SantiagoPreves/Trabajo-Final-CAN/docs/Figuras y graficos/montaje_protoboard.jpeg

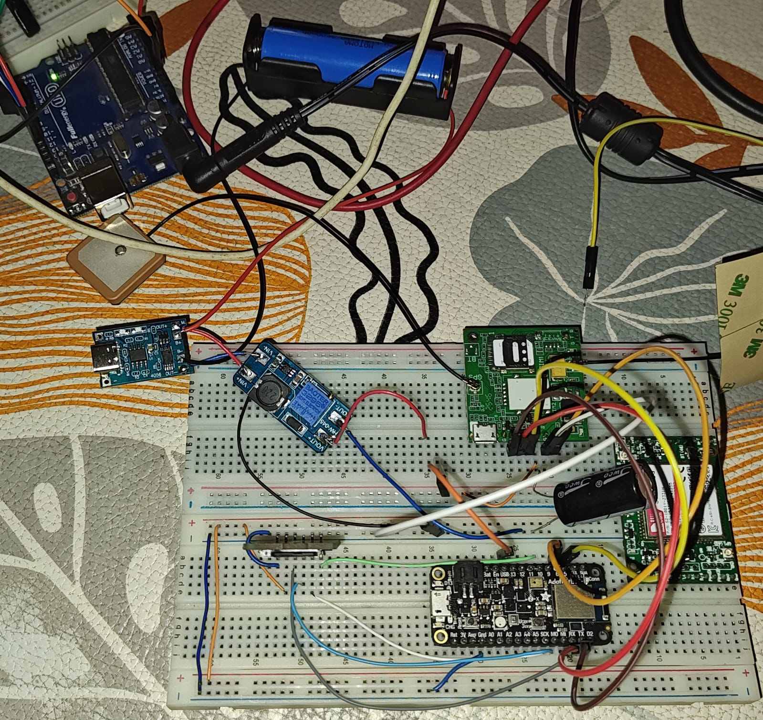
docs/Figuras y graficos/montaje_protoboard.jpeg
