SantiagoPreves/Trabajo-Final-CAN/docs/Figuras y graficos/gndopen.jpeg

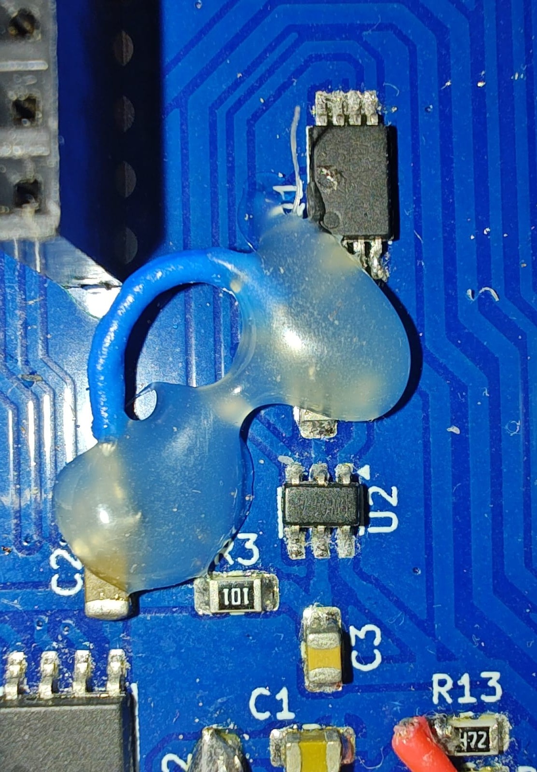
docs/Figuras y graficos/gndopen.jpeg
