SantiagoPreves/Trabajo-Final-CAN/docs/PProy_Preves_v1.pdf

Fecha: 25 de junio de 2026 | Versión 1.0

## UNMDP-FI

## Carrera: Ingeniería Electrónica

## Plan de Proyecto

## Sistema de monitoreo de fallas y datos de manejo de vehículos

Preves, Santiago

Sistema de monitoreo de fallas y datos de manejo de vehículos Plan de Proyecto

Fecha: 25/06/2026 | Versión 1.0 | Página 2 de 5
Fecha | Versión | Descripción | Autor/a
25/06/2026 | 1.0 | Versión inicial | Preves, Santiago

Índice

### 1. Introducción

Este documento contiene la especificación de requerimientos del proyecto de desarrollo de Sistema de monitoreo de fallas y datos de manejo de vehículos. Dicho proyecto se realiza en conjunto con el LIVRA, Facultad de Ingeniería, UNMDP.

- Título propuesto: “Sistema de monitoreo de fallas y datos de manejo de vehículos”.
- Estudiante: Preves, Santiago.
- Directores: Lopez, Juan Manuel - Director.
Russo, Rodrigo- Co-director.
- Lugar de desarrollo: Laboratorio de Instrumentación Virtual y Robótica Aplicada (LIVRA), Instituto de Investigaciones Científicas y Tecnológicas en Electrónica (ICyTE), UNMDP.

El siguiente documento corresponde al plan de proyecto, lo componen 3 partes:

- Cronograma preliminar propuesto
- Estimación de riesgos

### 2. Planificación

### 2.1 Cronograma propuesto

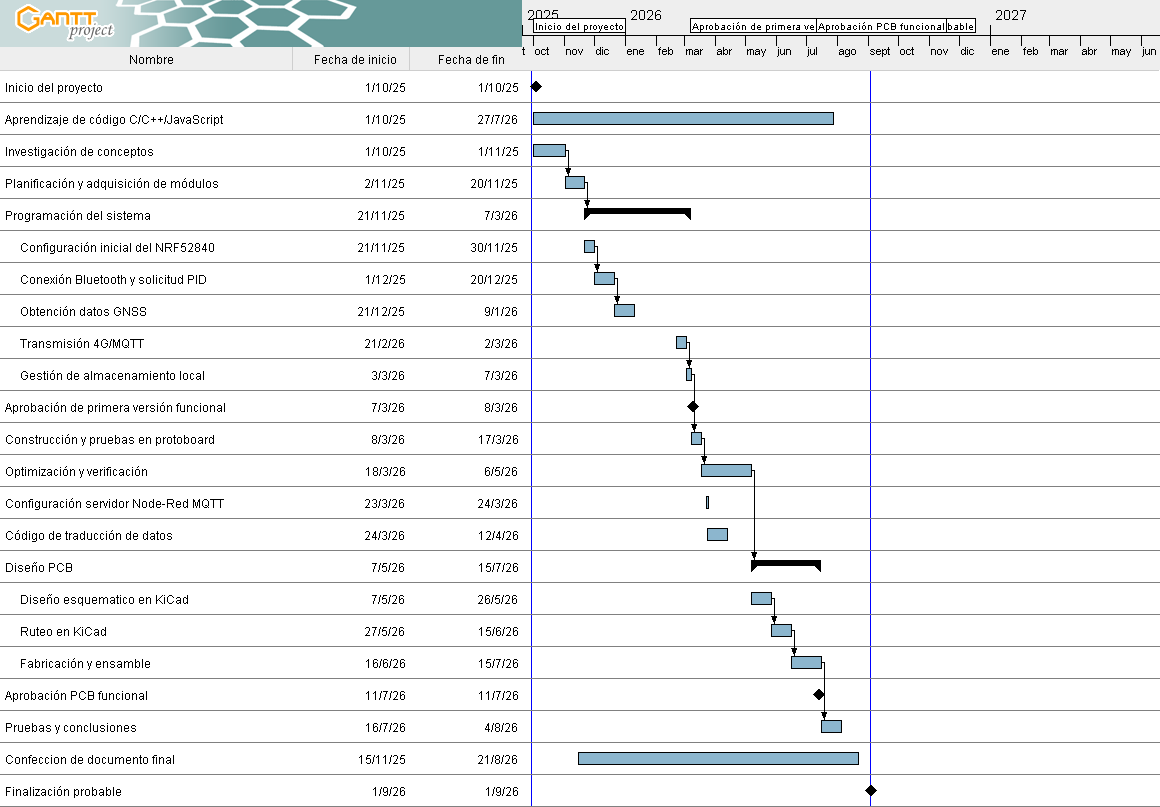
[picture p20: figure]

### 2.2 Riesgos identificados

El cronograma se realizó teniendo en cuenta tiempos extra en algunas tareas, con el fin de cubrirse de la aparición de inconvenientes con el fin de minimizar los efectos que estos puedan ocasionar en el cronograma.
En la siguiente tabla se detallan los riesgos considerados junto con la severidad, que es una medida del retraso que generaría en el cronograma. También se indica la probabilidad de que ese inconveniente aparezca. La combinación entre severidad y probabilidad da la medida de prioridad siendo los que tengan mayor severidad y mayor probabilidad una prioridad más alta.
Riesgo | Probabilidad de aparición | Severidad | Plan de respuesta
Comenzar a trabajar | Alta | Alta | Acelerar plazos previstos para esa fecha, de modo de compensar tiempos
Rotura de microcontrolador/módulo 4G | Baja | Alta | Adquisición de un nuevo módulo, se atrasa el calendario
Faltante en componentes | Baja | Baja | Se cambia de fabricante/se compra en el exterior
