SantiagoPreves/Trabajo-Final-CAN/docs/Figuras y graficos/carcasa1.png

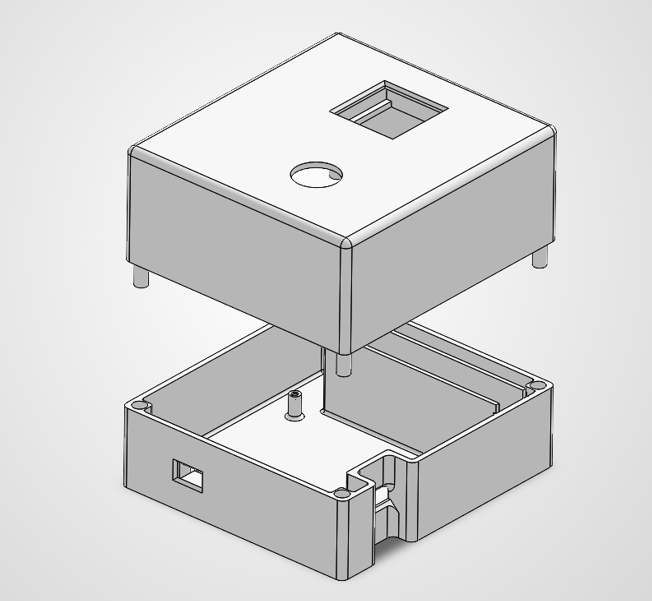
docs/Figuras y graficos/carcasa1.png
