SantiagoPreves/Trabajo-Final-CAN/docs/Figuras y graficos/carcasa2.png

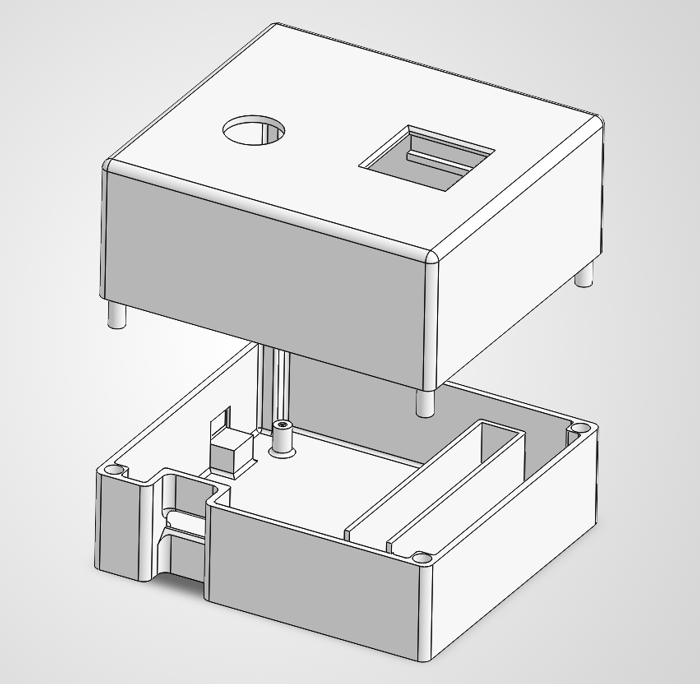
docs/Figuras y graficos/carcasa2.png
