SantiagoPreves/Trabajo-Final-CAN/docs/Figuras y graficos/carcasa_abierta.png

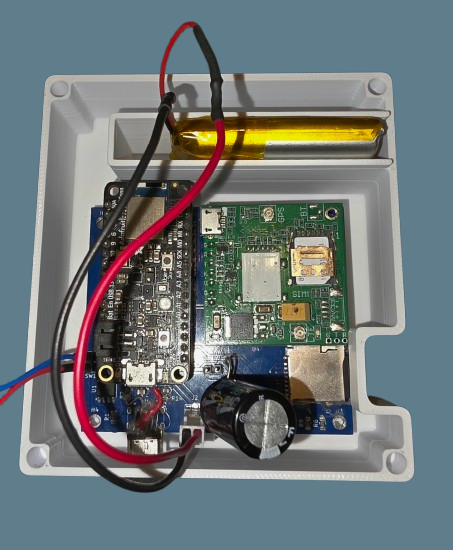
docs/Figuras y graficos/carcasa_abierta.png
