SantiagoPreves/Trabajo-Final-CAN/docs/Figuras y graficos/carcasa_general.png

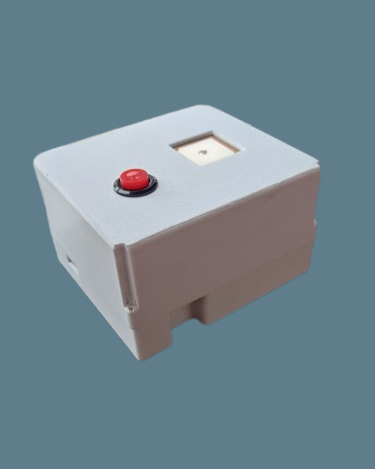
docs/Figuras y graficos/carcasa_general.png
