SantiagoPreves/Trabajo-Final-CAN/docs/Figuras y graficos/carcasa_superior.png

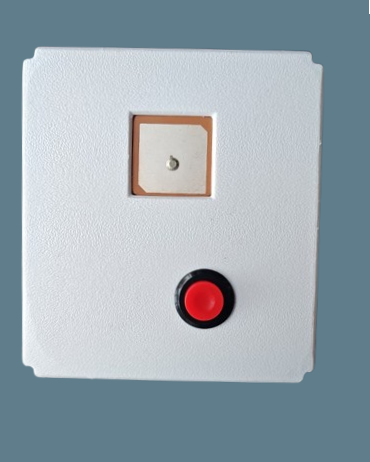
docs/Figuras y graficos/carcasa_superior.png
