SantiagoPreves/Trabajo-Final-CAN/docs/Figuras y graficos/GPS_bottom.png

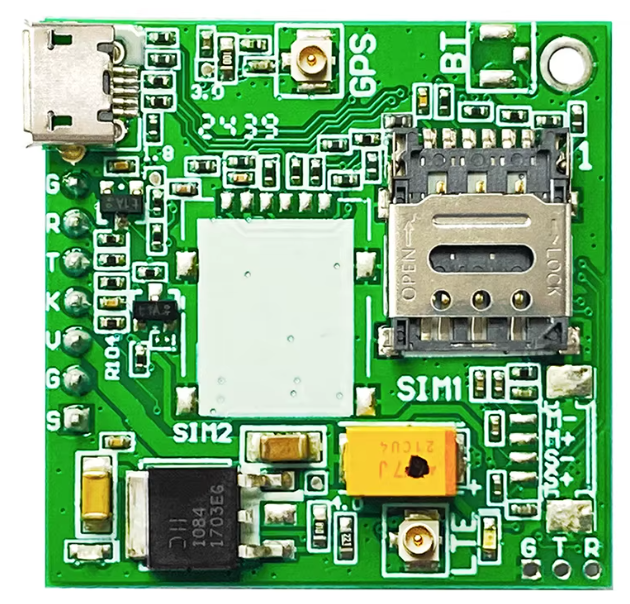
docs/Figuras y graficos/GPS_bottom.png
