SantiagoPreves/Trabajo-Final-CAN/docs/Figuras y graficos/GPS_top.png

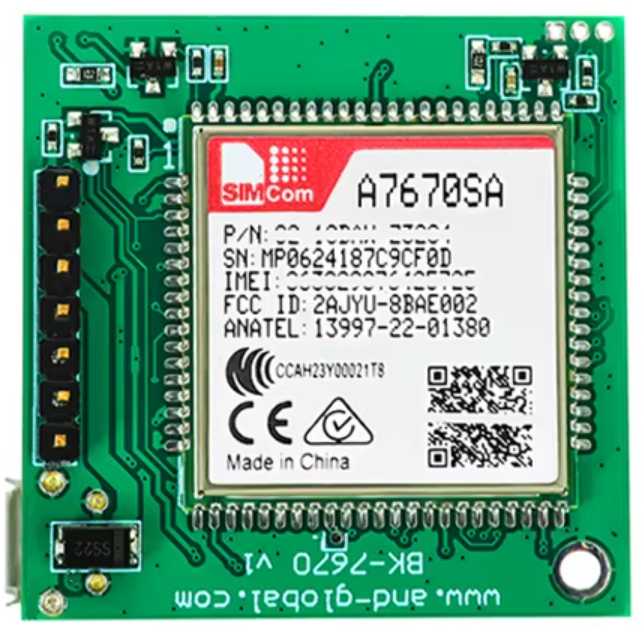
docs/Figuras y graficos/GPS_top.png
