SantiagoPreves/Trabajo-Final-CAN/docs/Figuras y graficos/micro_top.jpg

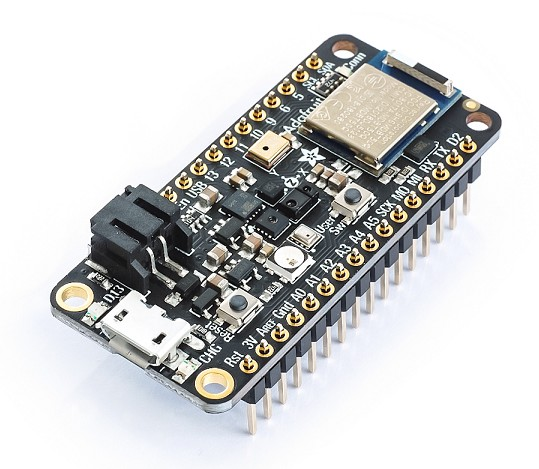
docs/Figuras y graficos/micro_top.jpg
