SantiagoPreves/Trabajo-Final-CAN/docs/Figuras y graficos/nodered.png

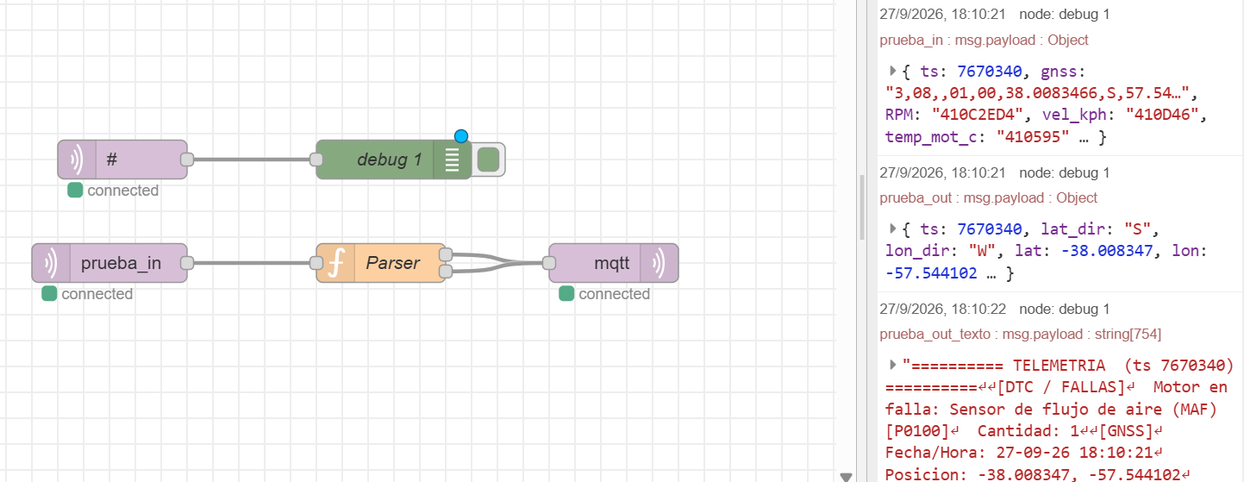
docs/Figuras y graficos/nodered.png
