SantiagoPreves/Trabajo-Final-CAN/docs/Figuras y graficos/SD_ejemplo.png

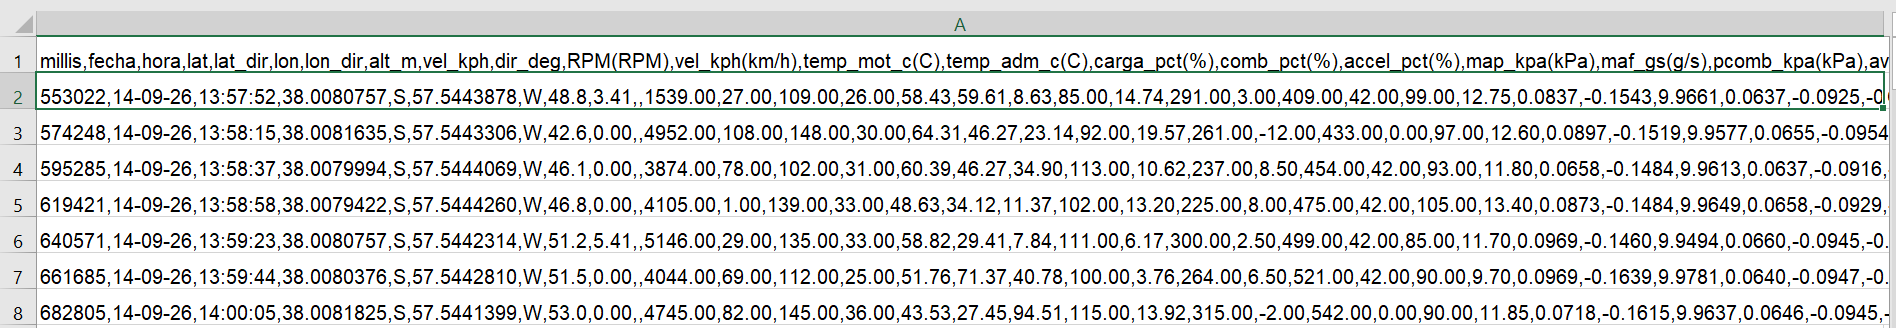
docs/Figuras y graficos/SD_ejemplo.png
