SantiagoPreves/Trabajo-Final-CAN/docs/Figuras y graficos/stencil.png

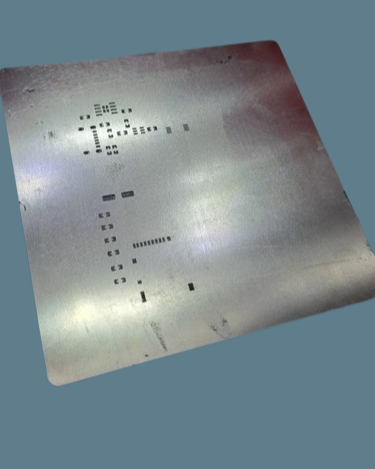
docs/Figuras y graficos/stencil.png
