SantiagoPreves/Trabajo-Final-CAN/test/mediciones_corriente_24-09/medicion_cada_15s.csv

No. | Date/Time | Function | Range | Value | Unit
1 | 2026-09-24 11:40:37 | DCmA | 60 | 0.00 | mA
2 | 2026-09-24 11:40:38 | DCmA | 600 | 0.0 | mA
3 | 2026-09-24 11:40:38 | DCmA | 600 | 72.6 | mA
4 | 2026-09-24 11:40:38 | DCmA | 600 | 73.0 | mA
5 | 2026-09-24 11:40:38 | DCmA | 600 | 74.0 | mA
6 | 2026-09-24 11:40:39 | DCmA | 600 | 81.3 | mA
7 | 2026-09-24 11:40:39 | DCmA | 600 | 81.1 | mA
8 | 2026-09-24 11:40:39 | DCmA | 600 | 81.3 | mA
9 | 2026-09-24 11:40:40 | DCmA | 600 | 80.1 | mA
10 | 2026-09-24 11:40:40 | DCmA | 600 | 77.8 | mA
11 | 2026-09-24 11:40:40 | DCmA | 600 | 106.1 | mA
12 | 2026-09-24 11:40:41 | DCmA | 600 | 94.5 | mA
13 | 2026-09-24 11:40:41 | DCmA | 600 | 104.0 | mA
14 | 2026-09-24 11:40:41 | DCmA | 600 | 92.0 | mA
15 | 2026-09-24 11:40:42 | DCmA | 600 | 201.9 | mA
16 | 2026-09-24 11:40:42 | DCmA | 600 | 231.0 | mA
17 | 2026-09-24 11:40:42 | DCmA | 600 | 298.7 | mA
18 | 2026-09-24 11:40:43 | DCmA | 600 | 296.2 | mA
19 | 2026-09-24 11:40:43 | DCmA | 600 | 277.7 | mA
20 | 2026-09-24 11:40:43 | DCmA | 600 | 151.8 | mA
21 | 2026-09-24 11:40:44 | DCmA | 600 | 80.3 | mA
22 | 2026-09-24 11:40:44 | DCmA | 600 | 83.3 | mA
23 | 2026-09-24 11:40:44 | DCmA | 600 | 76.6 | mA
24 | 2026-09-24 11:40:45 | DCmA | 600 | 81.9 | mA
25 | 2026-09-24 11:40:45 | DCmA | 600 | 74.2 | mA
26 | 2026-09-24 11:40:45 | DCmA | 600 | 76.0 | mA
27 | 2026-09-24 11:40:46 | DCmA | 600 | 82.8 | mA
28 | 2026-09-24 11:40:46 | DCmA | 600 | 80.5 | mA
29 | 2026-09-24 11:40:46 | DCmA | 600 | 76.7 | mA
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
645 | 2026-09-24 11:44:10 | DCmA | 600 | 271.0 | mA
646 | 2026-09-24 11:44:10 | DCmA | 600 | 251.0 | mA
647 | 2026-09-24 11:44:11 | DCmA | 600 | 236.3 | mA
648 | 2026-09-24 11:44:11 | DCmA | 600 | 236.3 | mA
649 | 2026-09-24 11:44:11 | DCmA | 600 | 234.9 | mA
