SantiagoPreves/Trabajo-Final-CAN/hardware/Kicad/Monitores_de_camiones/FS8205A/FS8205A.step

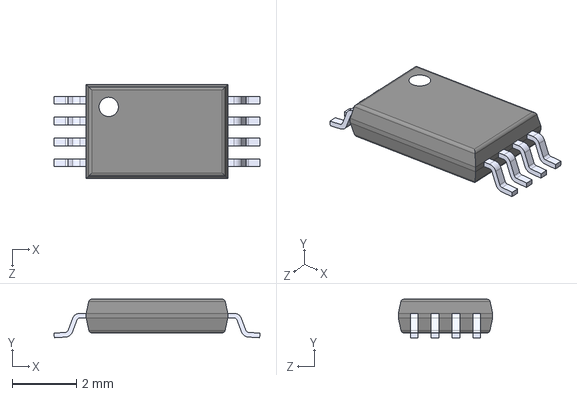
[picture p33: CAD file, 2026-09-22]
hardware/Kicad/Monitores_de_camiones/FS8205A/FS8205A.step
6.40 x 1.20 x 2.93 mm
