SantiagoPreves/Trabajo-Final-CAN/test/pruebas_anteriores/2026-09-13_dtc/trad.csv

millis | fecha | hora | lat | lat_dir | lon | lon_dir | alt_m | vel_kph | dir_deg | RPM(RPM) | vel_kph(km/h) | temp_mot_c(C) | temp_adm_c(C) | carga_pct(%) | comb_pct(%) | accel_pct(%) | map_kpa(kPa) | maf_gs(g/s) | pcomb_kpa(kPa) | avance_deg(deg) | ton_s(s) | dist_mil_km(km) | temp_ace_c(C) | cons_lh(L/h) | imu_ax(m/s2) | imu_ay(m/s2) | imu_az(m/s2) | imu_gx(rad/s) | imu_gy(rad/s) | imu_gz(rad/s) | vbat(V) | cargando | carga_completa | dtc | dtc_alerta
41723 |  |  |  |  |  |  |  |  |  | ERR | 101.00 | 145.00 | 20.00 | 54.90 | 22.75 | 18.82 | 107.00 | 7.50 | 243.00 | -2.50 | 1982.00 | 42.00 | 114.00 | 11.65 | -0.1256 | -0.2321 | 9.9649 | 0.0652 | -0.1032 | -0.0860 | 4.18 | 1 | 0 | P0100;U1000 | Motor en falla: Sensor de flujo de aire (MAF) [P0100] | Red/Comunicacion en falla: Comunicacion en red CAN [U1000]
62243 |  |  |  |  |  |  |  |  |  | 4927.00 | 67.00 | 145.00 | 31.00 | 55.69 | 65.10 | 80.78 | 115.00 | 5.24 | 213.00 | 4.50 | 2002.00 | 42.00 | 101.00 | 10.15 | -0.1268 | -0.2417 | 9.9829 | 0.0644 | -0.1009 | -0.0848 | 4.16 | 1 | 0 | P0100;U1000 | Motor en falla: Sensor de flujo de aire (MAF) [P0100] | Red/Comunicacion en falla: Comunicacion en red CAN [U1000]
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
