SantiagoPreves/Trabajo-Final-CAN/test/pruebas_anteriores/2026-09-27_rev5_15_ciclos/trad.csv

millis | fecha | hora | lat | lat_dir | lon | lon_dir | alt_m | vel_kph | dir_deg | RPM(RPM) | vel_kph(km/h) | temp_mot_c(C) | carga_pct(%) | accel_pct(%) | imu_ax(m/s2) | imu_ay(m/s2) | imu_az(m/s2) | imu_gx(rad/s) | imu_gy(rad/s) | imu_gz(rad/s) | vbat(V) | cargando | carga_completa | dtc
101351 |  |  |  |  |  |  |  |  |  | 2542.00 | 46.00 | 149.00 | 72.55 | 72.94 | 0.2668 | 0.5037 | 9.9984 | 0.0661 | -0.0904 | -0.1300 | 4.19 | 1 | 0 | U1000
302178 |  |  |  |  |  |  |  |  |  | 4040.00 | 30.00 | 122.00 | 73.33 | 94.51 | 0.2345 | 0.5121 | 9.9362 | 0.0672 | -0.0919 | -0.1271 | 4.12 | 1 | 0 | none
501611 |  |  |  |  |  |  |  |  |  | 5621.00 | 51.00 | 114.00 | 58.82 | 97.25 | 0.2321 | 0.5085 | 9.9003 | 0.0663 | -0.0886 | -0.1283 | 4.12 | 1 | 0 | P0100
703270 |  |  |  |  |  |  |  |  |  | 1548.00 | 113.00 | 144.00 | 48.24 | 8.63 | 0.2357 | 0.5109 | 9.8704 | 0.0658 | -0.0895 | -0.1280 | 4.12 | 1 | 0 | P0420;C0110
906619 |  |  |  |  |  |  |  |  |  | 3838.00 | 101.00 | 146.00 | 68.24 | 49.80 | 0.2572 | 0.5157 | 9.8728 | 0.0664 | -0.0878 | -0.1283 | 4.13 | 1 | 0 | B0010;U1000
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
