SantiagoPreves/Trabajo-Final-CAN/test/prueba_final/TRAD.CSV

millis | fecha | hora | lat | lat_dir | lon | lon_dir | alt_m | vel_kph | dir_deg | RPM(RPM) | vel_kph(km/h) | temp_mot_c(C) | carga_pct(%) | accel_pct(%) | imu_ax(m/s2) | imu_ay(m/s2) | imu_az(m/s2) | imu_gx(rad/s) | imu_gy(rad/s) | imu_gz(rad/s) | vbat(V) | cargando | carga_completa | dtc
106625 |  |  |  |  |  |  |  |  |  | 2879.00 | 23.00 | 126.00 | 58.82 | 44.71 | 0.0814 | 0.0526 | 9.9506 | 0.0632 | -0.0886 | -0.1126 | 4.17 | 1 | 0 | U0100;U0121
270035 | 27-09-26 | 19:07:01 | 38.0079651 | S | 57.5440445 | W | 107.4 | 2.17 | 0 | 2231.00 | 75.00 | 125.00 | 70.20 | 85.49 | 0.0682 | 0.0419 | 9.9326 | 0.0623 | -0.0916 | -0.1101 | 4.16 | 1 | 0 | P0420;U1000
450420 | 27-09-26 | 19:10:01 | 38.0080109 | S | 57.5440445 | W | 102.9 | 2.18 | 0 | 2183.00 | 8.00 | 117.00 | 60.78 | 20.00 | 0.0861 | 0.0383 | 9.9206 | 0.0632 | -0.0924 | -0.1101 | 4.17 | 1 | 0 | C0035;P0128
680596 | 27-09-26 | 19:13:51 | 38.0080299 | S | 57.5441360 | W | 64.4 | 0.58 | 0 | 2950.00 | 104.00 | 149.00 | 66.27 | 63.92 | 0.0646 | 0.0395 | 9.9266 | 0.0638 | -0.0933 | -0.1115 | 4.17 | 1 | 0 | C0035;P0128
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
