SantiagoPreves/Trabajo-Final-CAN/test/pruebas_anteriores/2026-09-10_sin_gestion/SD-sin-DTC-10-09.CSV

millis | fecha | hora | lat | lat_dir | lon | lon_dir | alt_m | vel_kph | dir_deg | RPM(RPM) | vel_kph(km/h) | temp_mot_c(C) | temp_adm_c(C) | carga_pct(%) | comb_pct(%) | accel_pct(%) | map_kpa(kPa) | maf_gs(g/s) | pcomb_kpa(kPa) | avance_deg(deg) | ton_s(s) | dist_mil_km(km) | temp_ace_c(C) | cons_lh(L/h) | imu_ax(m/s2) | imu_ay(m/s2) | imu_az(m/s2) | imu_gx(rad/s) | imu_gy(rad/s) | imu_gz(rad/s) | vbat(V) | cargando | carga_completa
69293 | 10-09-26 | 13:14:55 | 38.0125198 | S | 57.5814056 | W | 66.3 | 1.47 |  | ERR | 101.00 | 140.00 | 31.00 | 54.12 | 41.96 | 29.80 | 110.00 | 12.40 | 297.00 | 3.50 | 827.00 | 42.00 | 86.00 | 13.60 | 0.1304 | -0.3840 | 9.9960 | 0.0680 | -0.0939 | -0.1078 | 3.89 | 0 | 0
89220 | 10-09-26 | 13:15:18 | 38.0126572 | S | 57.5815392 | W | 60.2 | 3.29 |  | 2698.00 | 15.00 | 119.00 | 34.00 | 48.24 | 74.12 | 31.37 | 105.00 | 9.26 | 279.00 | -1.00 | 850.00 | 42.00 | 93.00 | 13.50 | 0.1161 | -0.3685 | 10.0056 | 0.0678 | -0.0950 | -0.1081 | 3.88 | 0 | 0
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
