SantiagoPreves/Trabajo-Final-CAN/test/mediciones_corriente_24-09/medicion_cada_5m_modo2.jpg

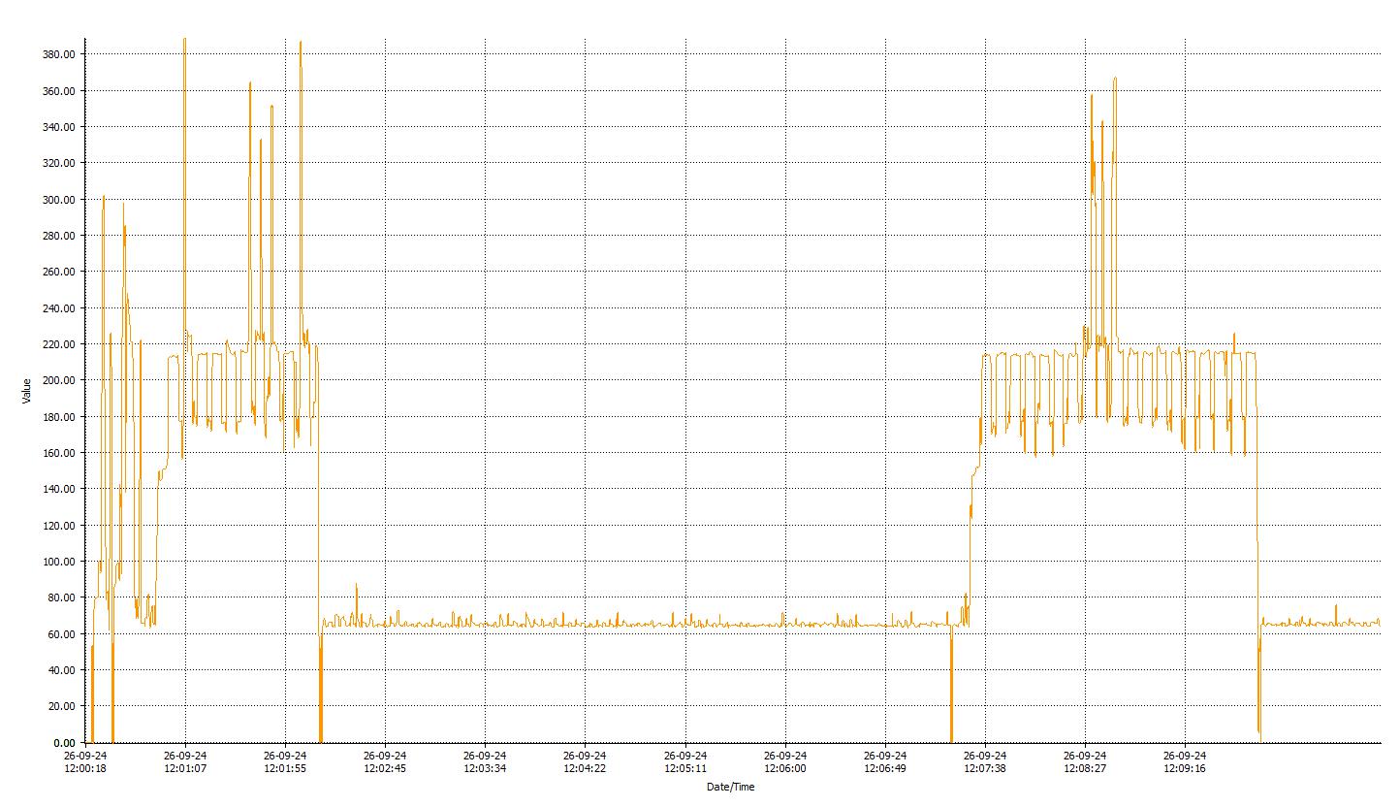
test/mediciones_corriente_24-09/medicion_cada_5m_modo2.jpg
