SantiagoPreves/Trabajo-Final-CAN/test/mediciones_corriente_24-09/medicion_cada_15s.jpg

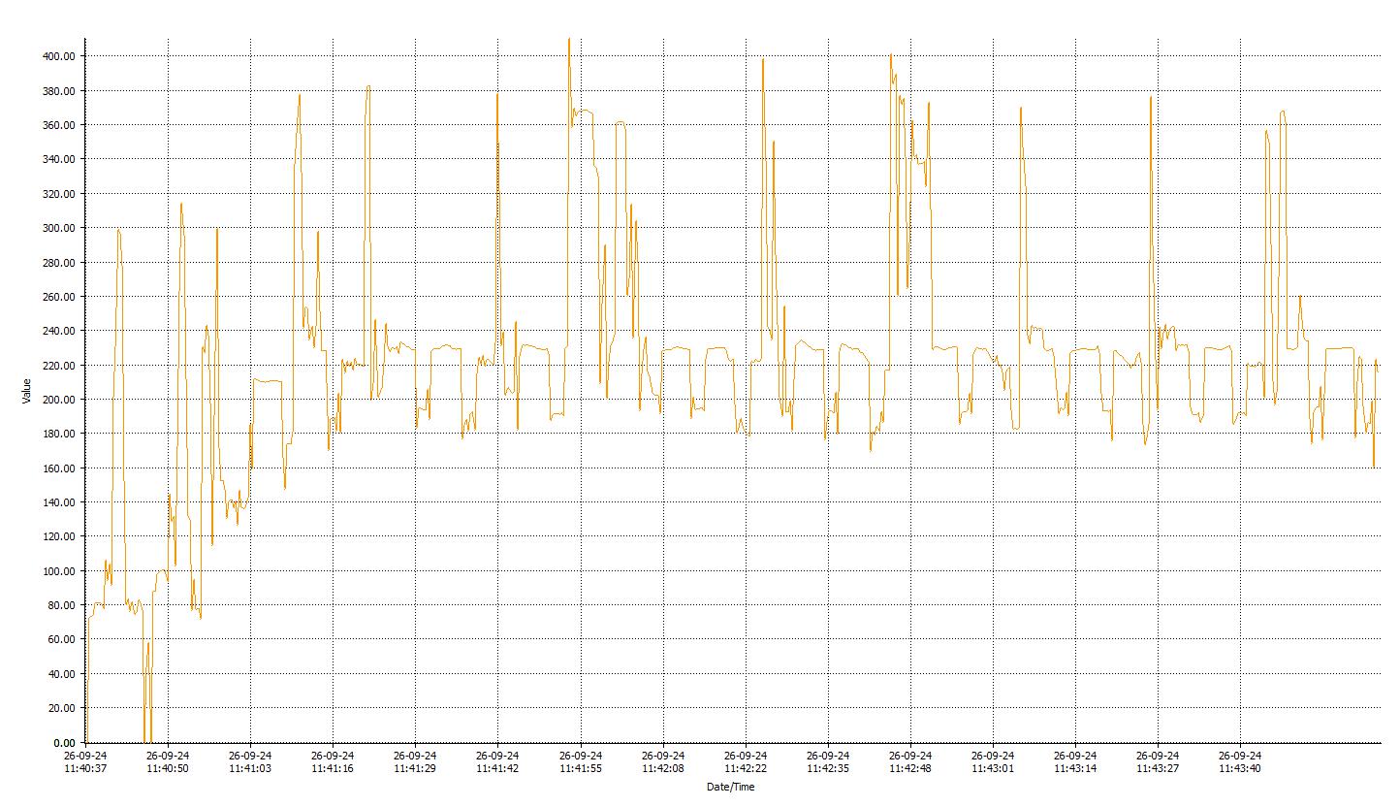
test/mediciones_corriente_24-09/medicion_cada_15s.jpg
