SantiagoPreves/Trabajo-Final-CAN/docs/Figuras y graficos/arquitectura_software.pdf

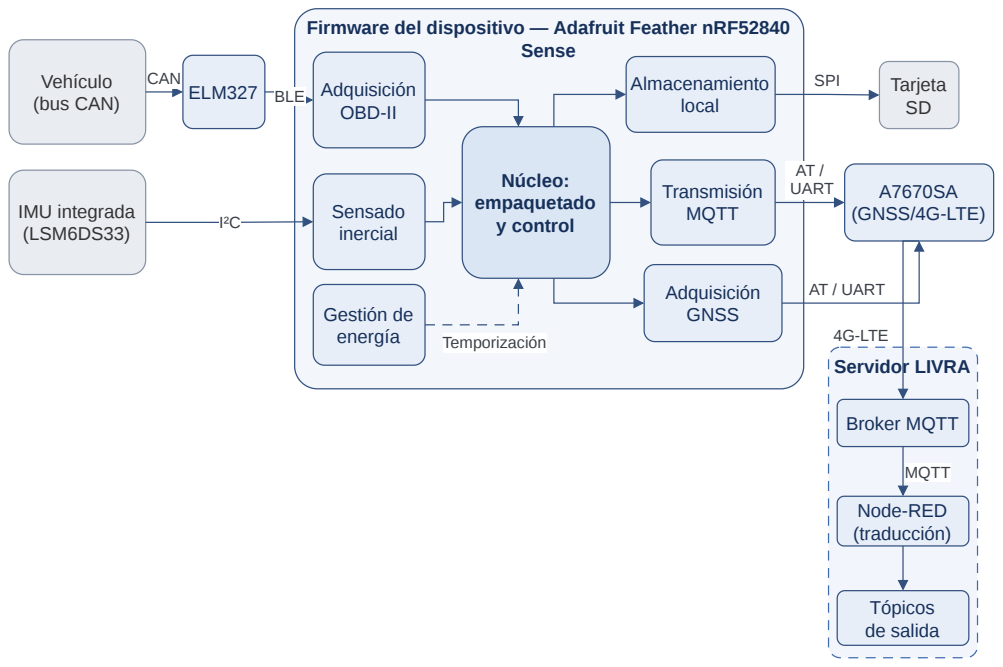
[picture p38: page 1]
Sense; Servidor LIVRA; Vehículo (bus CAN); IMU integrada (LSM6DS33); ELM327; Adquisición; OBD-II; Sensado inercial; Gestión de energía; Núcleo: empaquetado y control; Almacenamiento local; Transmisión MQTT; Adquisición GNSS; Tarjeta SD; A7670SA (GNSS/4G-LTE); Broker MQTT; Node-RED (traducción); Tópicos de salida; CAN; BLE; I²C; Temporización; SPI; AT / UART; 4G-LTE; MQTT

Firmware del dispositivo — Adafruit Feather nRF52840
