SantiagoPreves/Trabajo-Final-CAN/docs/Figuras y graficos/desarrollo_incremental_A4.pdf

## en paralelo

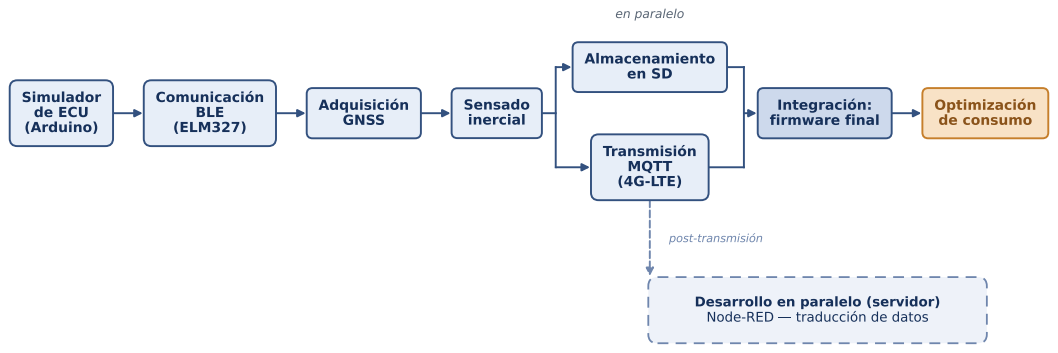
[picture p39: page 1]
Simulador de ECU (Arduino); Comunicación BLE (ELM327); Adquisición GNSS; Sensado inercial; Integración: firmware final; Optimización de consumo; Almacenamiento en SD; Transmisión MQTT (4G-LTE); post-transmisión

Desarrollo en paralelo (servidor)
Node-RED traducción de datos
