SantiagoPreves/Trabajo-Final-CAN/docs/Figuras y graficos/secuencia_software_A4.pdf

## ELM327 (Vehículo)

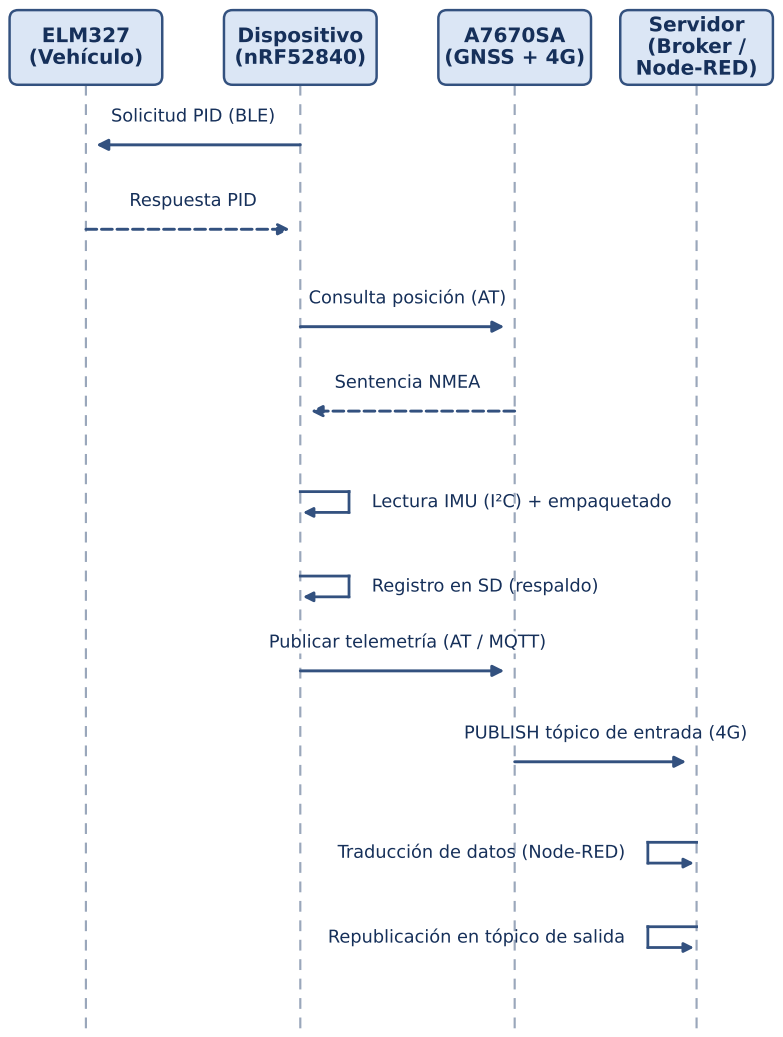
[picture p40: page 1]
Dispositivo (nRF52840); A7670SA (GNSS + 4G); Servidor (Broker / Node-RED); Respuesta PID; Sentencia NMEA; Traducción de datos; (Node-RED)

Solicitud PID (BLE)

Consulta posición (AT)

Lectura IMU (I²C) + empaquetado

Registro en SD (respaldo)

Publicar telemetría (AT / MQTT)

PUBLISH tópico de entrada (4G)

Republicación en tópico de salida
