SantiagoPreves/Trabajo-Final-CAN/hardware/esquematico.pdf

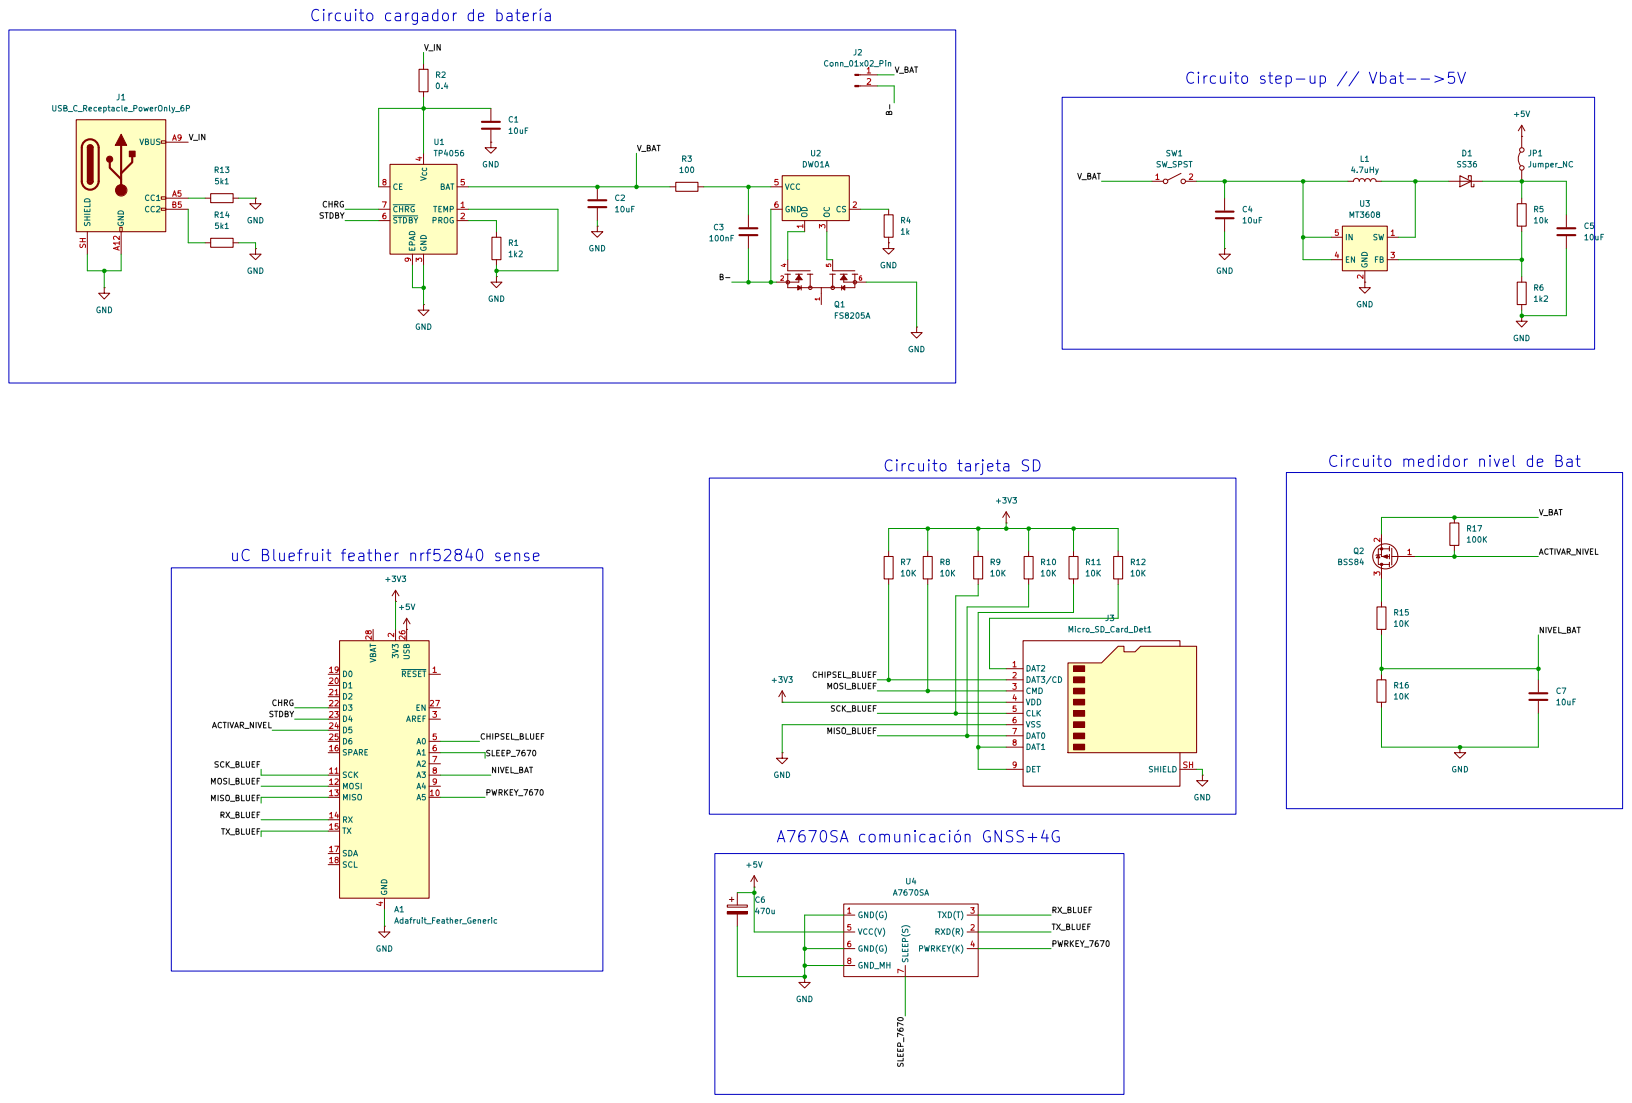
[picture p41: page 1]
