SantiagoPreves/Trabajo-Final-CAN/hardware/Kicad/Monitores_de_camiones/Monitores_de_camiones.kicad_pcb

## KiCad design hardware/Kicad/Monitores_de_camiones/Monitores_de_camiones.kicad_pcb (2026-09-22)

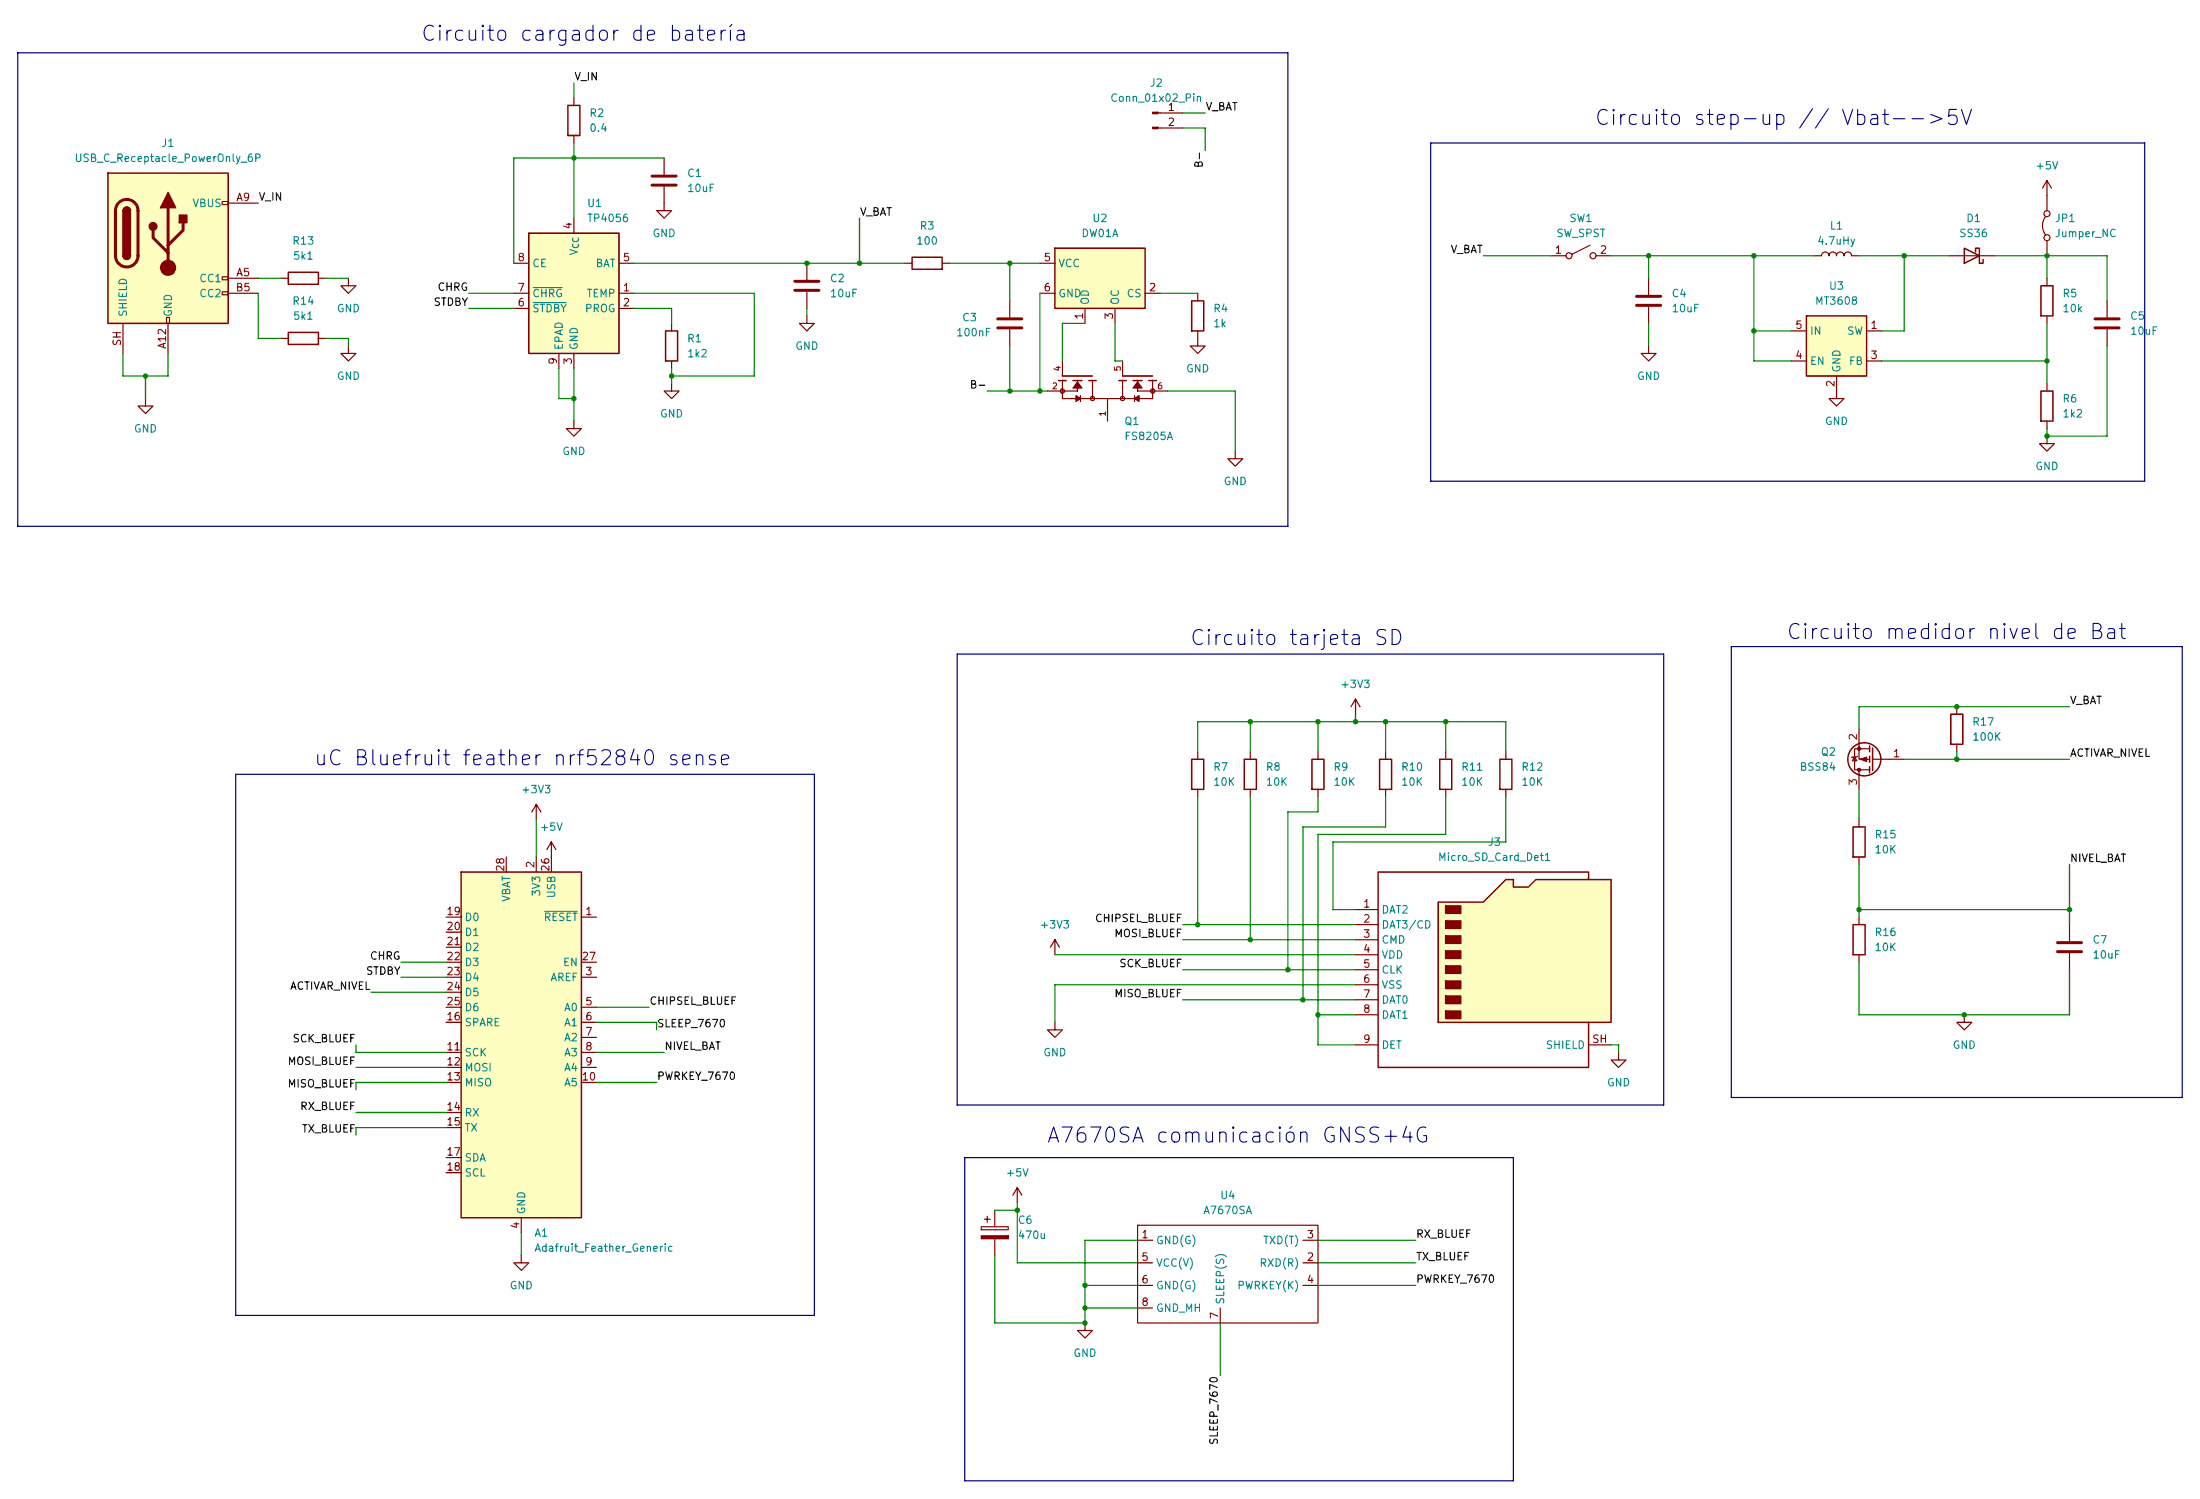
[picture p42: schematic Monitores_de_camiones.kicad_sch, Proyecto Final]

Parts:
A1: Adafruit_Feather_Generic; Adafruit_Feather
C1, C2, C7: 10uF; C_0805_2012Metric_Pad1.18x1.45mm_HandSolder
C3: 100nF; C_0805_2012Metric_Pad1.18x1.45mm_HandSolder
C4, C5: 10uF; C_1206_3216Metric_Pad1.33x1.80mm_HandSolder
C6: 470u; CP_Elec_6.3x5.2
D1: SS36; D_SMA
J1: USB_C_Receptacle_PowerOnly_6P; USB_C_Receptacle_GCT_USB4125-xx-x-0190_6P_TopMnt_Horizontal
J2: Conn_01x02_Pin; Molex_KK-254_AE-6410-02A_1x02_P2.54mm_Vertical
J3: Micro_SD_Card_Det1; microSD_HC_Hirose_DM3AT-SF-PEJM5
JP1: Jumper_NC; PinHeader_1x02_P2.54mm_Vertical
L1: 4.7uHy; L_Wuerth_WE-PDF_Handsoldering
Q1: FS8205A; FS8205A_TSSOP-8; PARTREV 1.7
Q2: BSS84; SOT-23
R1, R6: 1k2; R_0805_2012Metric_Pad1.20x1.40mm_HandSolder
R2: 0.4; R_0805_2012Metric_Pad1.20x1.40mm_HandSolder
R3: 100; R_0805_2012Metric_Pad1.20x1.40mm_HandSolder
R4: 1k; R_0805_2012Metric_Pad1.20x1.40mm_HandSolder
R5: 10k; R_0805_2012Metric_Pad1.20x1.40mm_HandSolder
R7, R8, R9, R10, R11, R12, R15, R16: 10K; R_0805_2012Metric_Pad1.20x1.40mm_HandSolder
R13, R14: 5k1; R_0805_2012Metric_Pad1.20x1.40mm_HandSolder
R17: 100K; R_0805_2012Metric_Pad1.20x1.40mm_HandSolder
SW1: SW_SPST; PinHeader_1x02_P2.54mm_Vertical
U1: TP4056; SOIC-8-1EP_3.9x4.9mm_P1.27mm_EP2.41x3.3mm_ThermalVias
U2: DW01A; SOT-23-6
U3: MT3608; SOT-23-6
U4: A7670SA

Connections:
+3V3: A1.2 (3V3), J3.4 (VDD), R7.1, R8.1, R9.1, R10.1, R11.1, R12.1
+5V: A1.26 (USB), C6.1, JP1.2 (B), U4.5 (VCC(V))
/ACTIVAR_NIVEL: A1.24 (D5), Q2.1 (G), R17.2
/B-: C3.2, J2.2, Q1.2, Q1.3, U2.6 (GND)
/CHIPSEL_BLUEF: A1.5 (A0), J3.2 (DAT3/CD), R7.2
/CHRG: A1.22 (D3), U1.7 (~CHRG)
/MISO_BLUEF: A1.13 (MISO), J3.7 (DAT0), R10.2
/MOSI_BLUEF: A1.12 (MOSI), J3.3 (CMD), R8.2
/NIVEL_BAT: A1.8 (A3), C7.1, R15.2, R16.1
/PWRKEY_7670: A1.10 (A5), U4.4 (PWRKEY(K))
/RX_BLUEF: A1.14 (RX), U4.3 (TXD(T))
/SCK_BLUEF: A1.11 (SCK), J3.5 (CLK), R9.2
/SLEEP_7670: A1.6 (A1), U4.7 (SLEEP(S))
/STDBY: A1.23 (D4), U1.6 (~STDBY)
/TX_BLUEF: A1.15 (TX), U4.2 (RXD(R))
/V_BAT: C2.1, J2.1, Q2.2 (S), R3.1, R17.1, SW1.1 (A), U1.5 (BAT)
/V_IN: J1.A9 (VBUS), J1.B9 (VBUS), R2.1
GND: A1.4 (GND), C1.2, C2.2, C4.2, C5.2, C6.2, C7.2, J1.A12 (GND), J1.B12 (GND), J1.SH (SHIELD), J3.6 (VSS), J3.SH (SHIELD), Q1.6, Q1.7, R1.2, R4.2, R6.2, R13.2, R14.2, R16.2, U1.1 (TEMP), U1.3 (GND), U1.9 (EPAD), U3.2 (GND), U4.1 (GND(G)), U4.6 (GND(G)), U4.8 (GND_MH)
unnamed: D1.2 (A), L1.2, U3.1 (SW)
unnamed: C5.1, D1.1 (K), JP1.1 (A), R5.1
unnamed: J1.A5 (CC1), R13.1
unnamed: J1.B5 (CC2), R14.1
unnamed: J3.8 (DAT1), J3.9 (DET), R11.2
unnamed: J3.1 (DAT2), R12.2
unnamed: Q1.1, Q1.8
unnamed: Q2.3 (D), R15.1
unnamed: C4.1, L1.1, SW1.2 (B), U3.4 (EN), U3.5 (IN)
unnamed: C1.1, R2.2, U1.4 (V_{CC}), U1.8 (CE)
unnamed: R1.1, U1.2 (PROG)
unnamed: R4.1, U2.2 (CS)
unnamed: Q1.5, U2.3 (OC)
unnamed: Q1.4, U2.1 (OD)
unnamed: C3.1, R3.2, U2.5 (VCC)
unnamed: R5.2, R6.1, U3.3 (FB)

Notes on the sheet:
A7670SA comunicación GNSS+4G
Circuito tarjeta SD
Circuito cargador de batería
Circuito medidor nivel de Bat
Circuito step-up // Vbat-->5V
uC Bluefruit feather nrf52840 sense

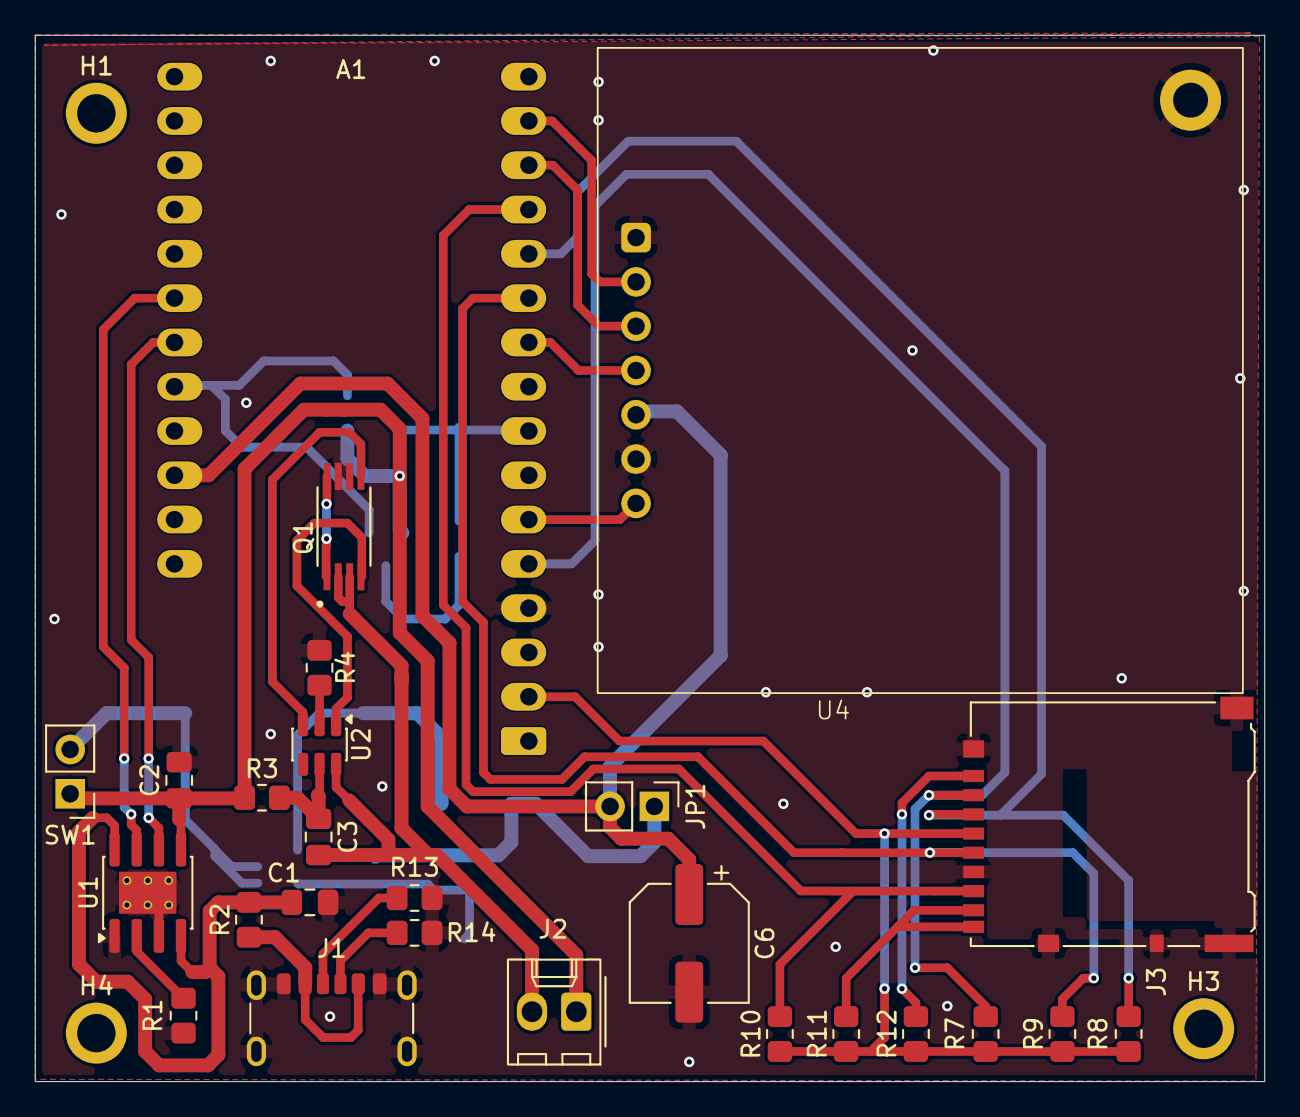
[picture p43: board Monitores_de_camiones.kicad_pcb from above]

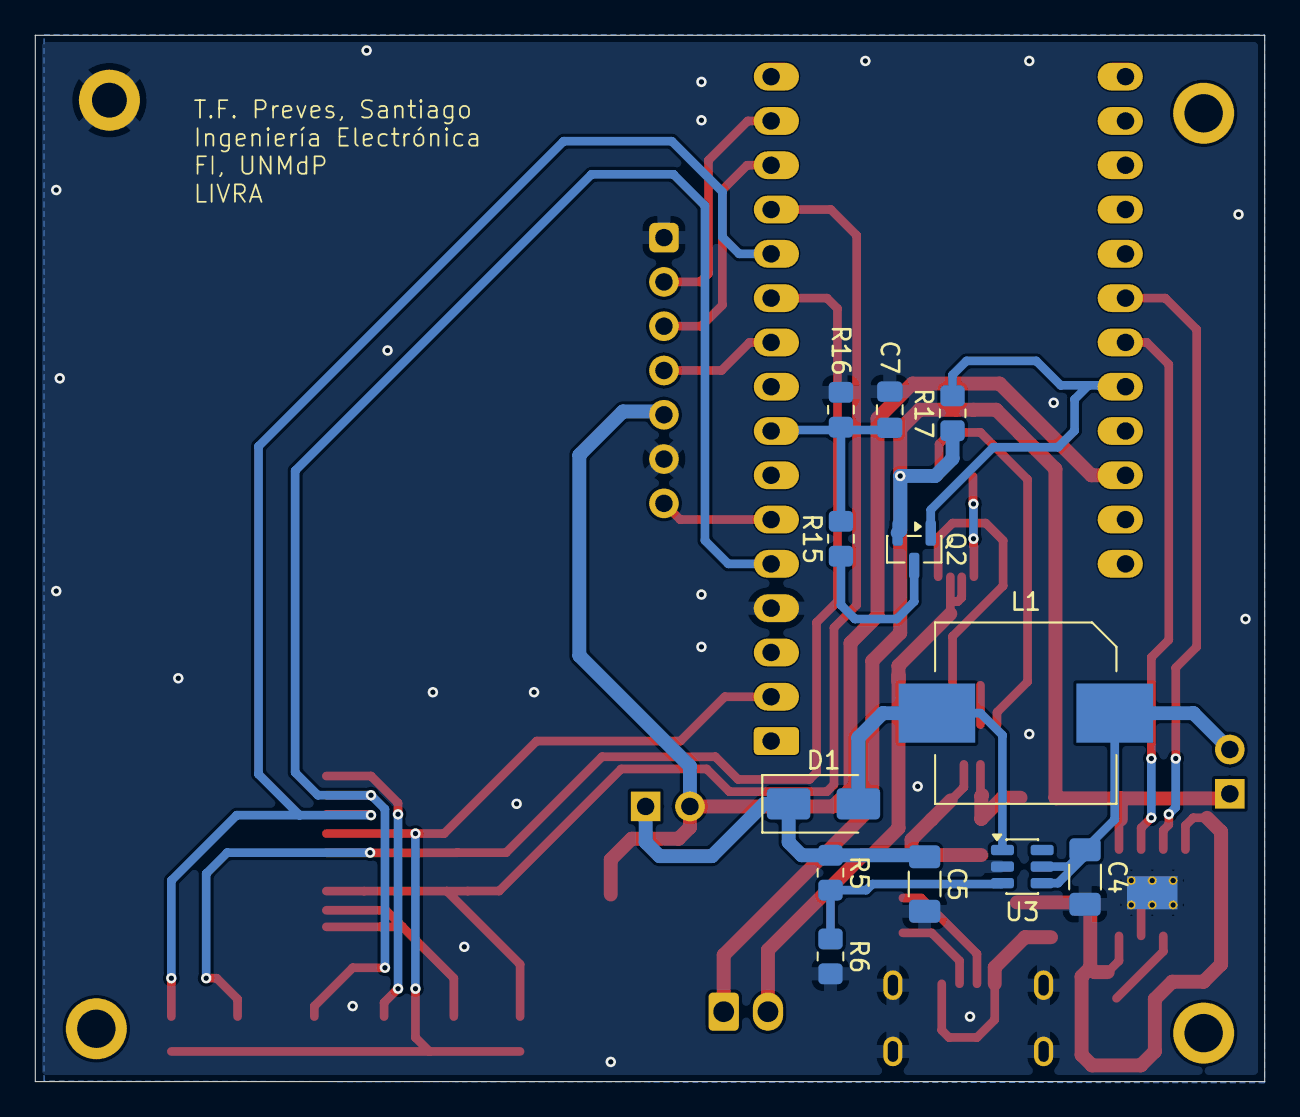
[picture p44: board Monitores_de_camiones.kicad_pcb from below]

Board: 2 copper layers, 70.5 x 60.0 mm, 41 parts (12 on the bottom side), 34 nets.

Other parts of the board:
H1, H3, H4: MountingHole_2.2mm_M2_ISO7380_Pad
