SantiagoPreves/Trabajo-Final-CAN/(commit log)

2026-09-22 reestructuración y carga de archivos
    [FS8205A.step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]
2026-09-27 Correccion de error en repositorio
    [CAN_simulator_V3_raw.ino, Packet.cpp, monitoreo-completo.ino]
2026-09-27 Nueva carpeta firmware con primeras versiones de codigo
2026-09-28 Organización de las pruebas y README
    [SD-DTC.CSV, SD-sin-DTC-10-09.CSV, TRAD.CSV, medicion_cada_15s.csv, medicion_cada_5min.csv, medicion_cada_5min_modo2.csv, medicion_cada_5min_modo2_gpsoff.csv, trad.csv]
2026-10-02 Actualizacion de docs
    [PP_Preves_V1.xlsx]
